ManCaveMade/ESP-Live/README.md

# ESP-Live
An ESP8266 (ESP-12F) board with USB and Mains power supply for home automation applications.
