ManCaveMade/ESP-Live/ESPLive-v2/ESPLiveDC.brd

## EAGLE design ESPLive-v2/ESPLiveDC.brd (2017-08-18)

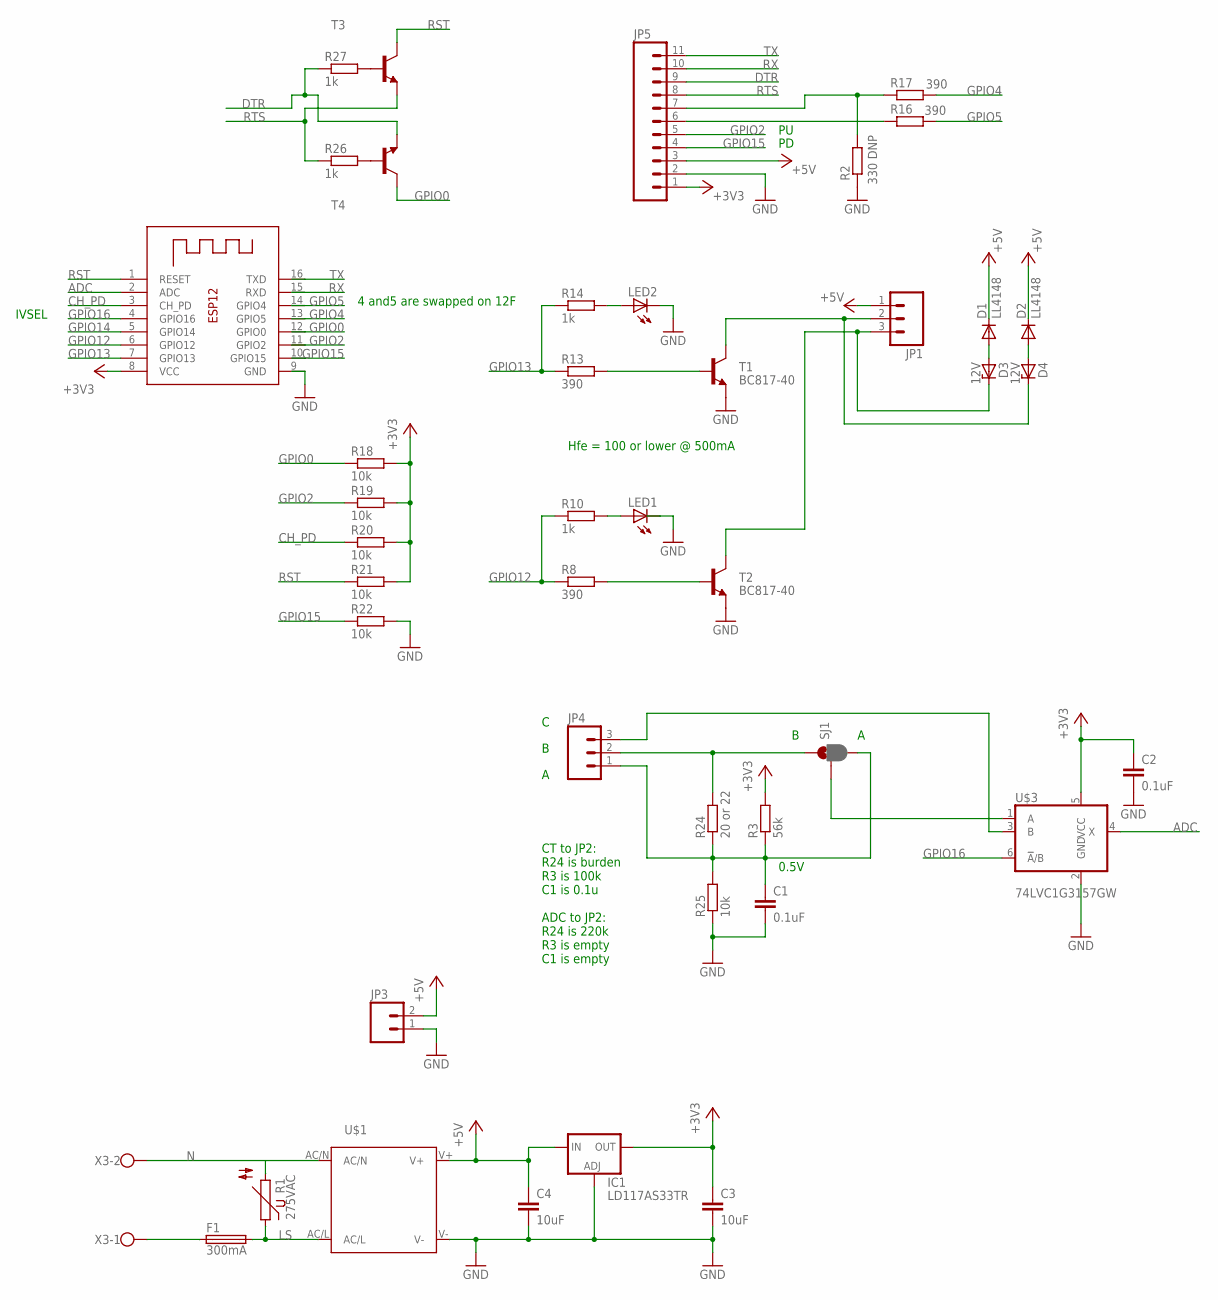
[picture p1: schematic ESPLiveDC.sch]

Parts:
C1, C2: 0.1uF; C0603
C3, C4: 10uF; C0805
D1, D2: LL4148; SOD80C
D3, D4: 12V; SOD80C
F1: 300mA; TE5
IC1: LD117AS33TR; SOT223
JP1, JP4: M03POLAR_LOCK; MOLEX-1X3_LOCK
JP3: M02POLAR_LOCK; MOLEX-1X2_LOCK
JP5: M11LOCK; 1X11_LOCK
LED1, LED2: LED1206; LED-1206
R1: 275VAC; P593
R2: 330 DNP; R0603
R3: 56k; R0603
R8, R13, R16, R17: 390; R0603
R10, R14, R26, R27: 1k; R0603
R18, R19, R20, R21, R22, R25: 10k; R0603
R24: 20 or 22; R1206
SJ1: JUMPER-PAD-3-2OF3_NC_BY_PASTE; PAD-JUMPER-3-2OF3_NC_BY_PASTE_YES_SILK_FULL_BOX
T1, T2: BC817-40; SOT23-BEC
T3, T4: BC817-40-NPN-SOT23-BEC; SOT23-BEC
U$1: IRM_01/02_SMDIRM_01/02_SMD; IRM_01/02_SMD
U$3: 74LVC1G3157GW; SOT363
X1: ESP-12
X3: W237-102

Connections:
+3V3: C2.1, C3.1, IC1.4 (OUT), JP5.1, R3.2, R18.2, R19.2, R20.2, R21.2, U$3.5 (VCC), X1.8 (VCC)
+5V: C4.1, D1.C, D2.C, IC1.3 (IN), JP1.1, JP3.2, JP5.3, U$1.V+
ADC: U$3.4 (X), X1.2 (ADC)
CH_PD: R20.1, X1.3 (CH_PD)
DTR: JP5.9, R27.1, T4.E
GND: C1.2, C2.2, C3.2, C4.2, IC1.1 (ADJ), JP3.1, JP5.2, LED1.C, LED2.C, R2.1, R22.2, R25.1, T1.E, T2.E, U$1.V-, U$3.2 (GND), X1.9 (GND)
GPIO0: R18.1, T4.C, X1.12 (GPIO0)
GPIO2: JP5.5, R19.1, X1.11 (GPIO2)
GPIO4: R17.2, X1.13 (GPIO5)
GPIO5: R16.2, X1.14 (GPIO4)
GPIO12: R8.1, R10.1, X1.6 (GPIO12)
GPIO13: R13.1, R14.1, X1.7 (GPIO13)
GPIO14: X1.5 (GPIO14)
GPIO15: JP5.4, R22.1, X1.10 (GPIO15)
GPIO16: U$3.6 (!A!/B), X1.4 (GPIO16)
LS: F1.2, R1.1, U$1.AC/L
N: R1.2, U$1.AC/N, X3.2
unnamed: R13.2, T1.B
unnamed: LED1.A, R10.2
unnamed: R8.2, T2.B
unnamed: D4.C, JP1.2, T1.C
unnamed: D3.C, JP1.3, T2.C
unnamed: F1.1, X3.1
unnamed: D1.A, D3.A
unnamed: D2.A, D4.A
unnamed: C1.1, JP4.1, R3.1, R24.1, R25.2, SJ1.3
unnamed: JP4.2, R24.2, SJ1.1
unnamed: SJ1.2, U$3.1 (A)
unnamed: JP4.3, U$3.3 (B)
unnamed: LED2.A, R14.2
unnamed: JP5.6, R16.1
unnamed: JP5.7, R2.2, R17.1
unnamed: R26.2, T4.B
unnamed: R27.2, T3.B
RST: R21.1, T3.C, X1.1 (RESET)
RTS: JP5.8, R26.1, T3.E
RX: JP5.10, X1.15 (RXD)
TX: JP5.11, X1.16 (TXD)

Notes on the sheet:
IVSEL
Hfe = 100 or lower @ 500mA
4 and5 are swapped on 12F
CT to JP2: R24 is burden R3 is 100k C1 is 0.1u ADC to JP2: R24 is 220k R3 is empty C1 is empty
0.5V

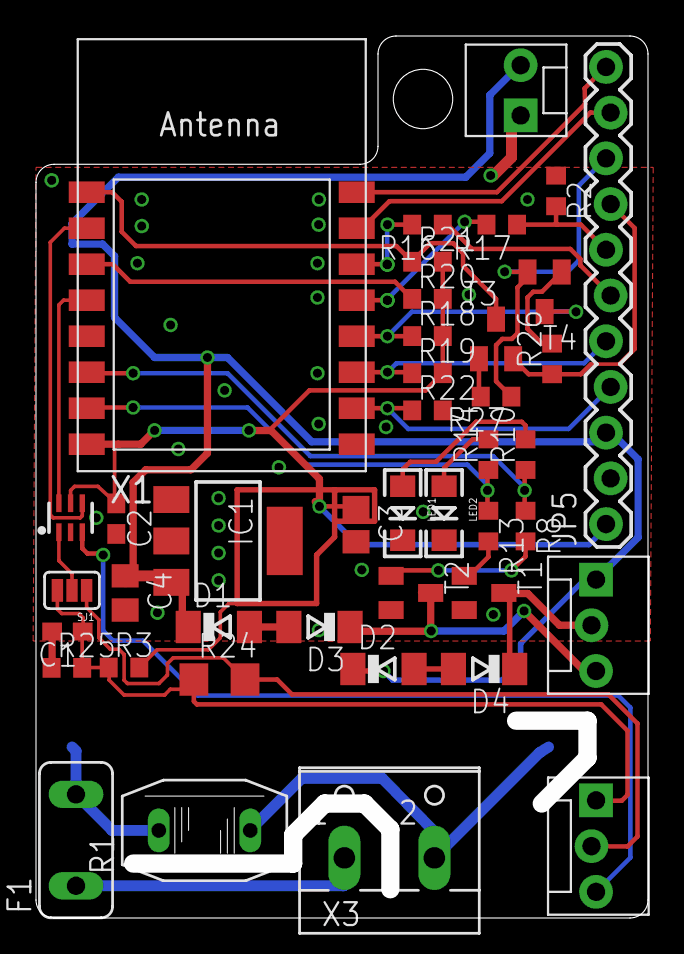
[picture p2: board ESPLiveDC.brd from above]

Board: 2 copper layers, 34.0 x 49.0 mm, 43 parts (1 on the bottom side), 37 nets.
