ManCaveMade/ESP-Live/(commit log)

2016-12-27 Version 1. Works perfectly but have not tested the CH340 yet.
    [ELDimmer.brd, ELDimmer.sch, ESP-Live BOM.xlsx, ESP-Live.brd, ESP-Live.sch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]
2016-12-27 Added v2 directory, ready for some significant enhancements to the design:
    * Remove CH340 and replace with STM32 with USB-CDC
    * Use the STM32 for analog functions + PWM, etc. since ESP is bad at that
    * Implement connections from ESP for OTA programming of STM32 (if possible)
    * Make pins on ESP-Live dual role / remove the useless ones from the ESP such as ADC, CH_PD, etc. and connect directly to STM32 intead.
    [ESP-Live.brd, ESP-Live.sch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]
2017-01-08 with batery charger
    [ESP-Live.brd, ESP-Live.sch]
2017-08-18 added esplive v2
    [ELDimmer.brd, ELDimmer.sch, ESP-Live BOM.xlsx, ESP-Live.brd, ESP-Live.sch, ESPLiveDC.brd, ESPLiveDC.sch]
